Matricule17060/WirelessMonitoringProject/README.md

# WirelessMonitoringProject

https://user-images.githubusercontent.com/74556373/141704648-909ced50-29ef-4647-8402-63f720a56d8c.mp4
