Matricule17060/WirelessMonitoringProject/Annexes/Datasheet_Arduino.jpg

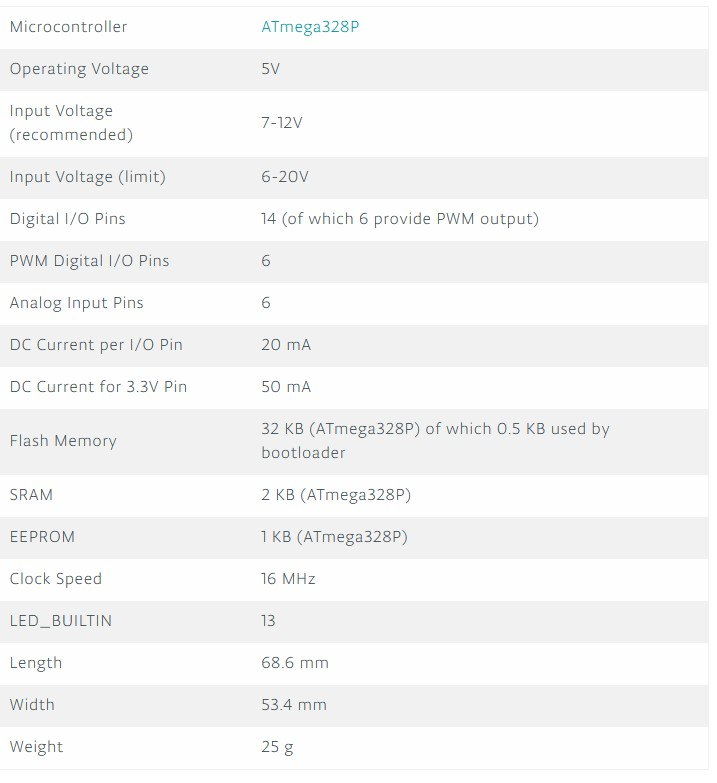
Annexes/Datasheet_Arduino.jpg
