Matricule17060/WirelessMonitoringProject/Annexes/MOTOR.PNG

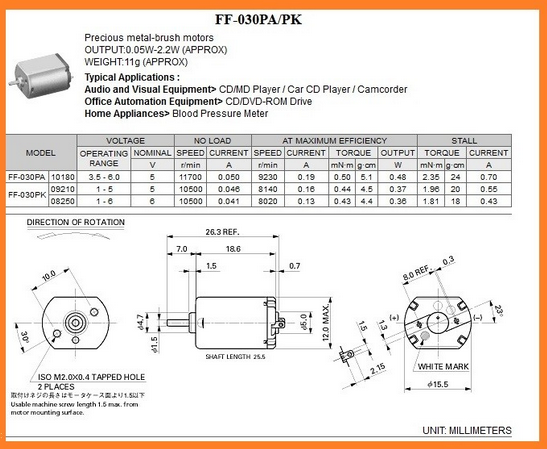
Annexes/MOTOR.PNG
