Matricule17060/WirelessMonitoringProject/Software/pulsOximeter/245952259_6285940131448196_2866411864842112487_n.png

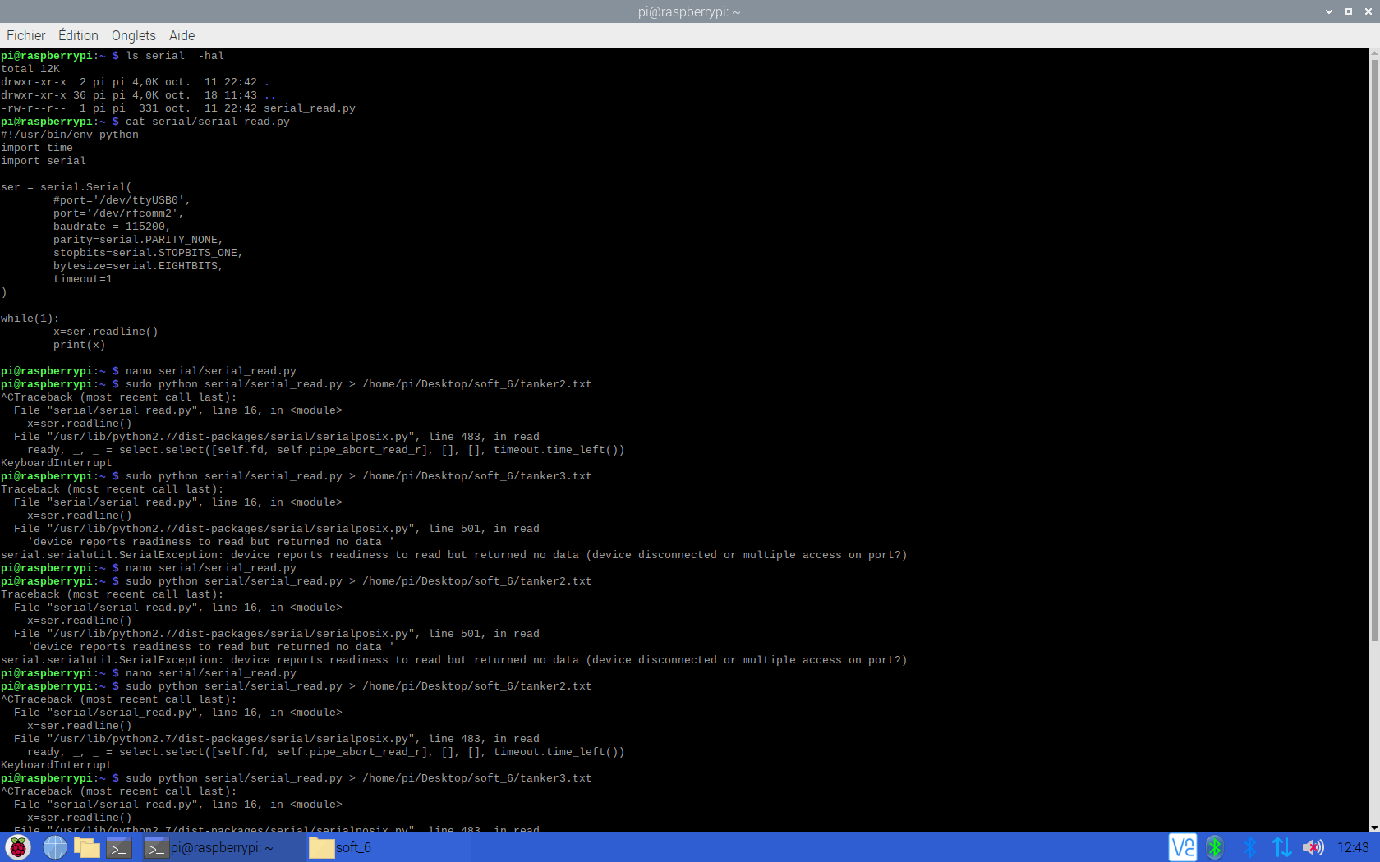
Software/pulsOximeter/245952259_6285940131448196_2866411864842112487_n.png
