Matricule17060/WirelessMonitoringProject/Software/pulsOximeter/plot1.PNG

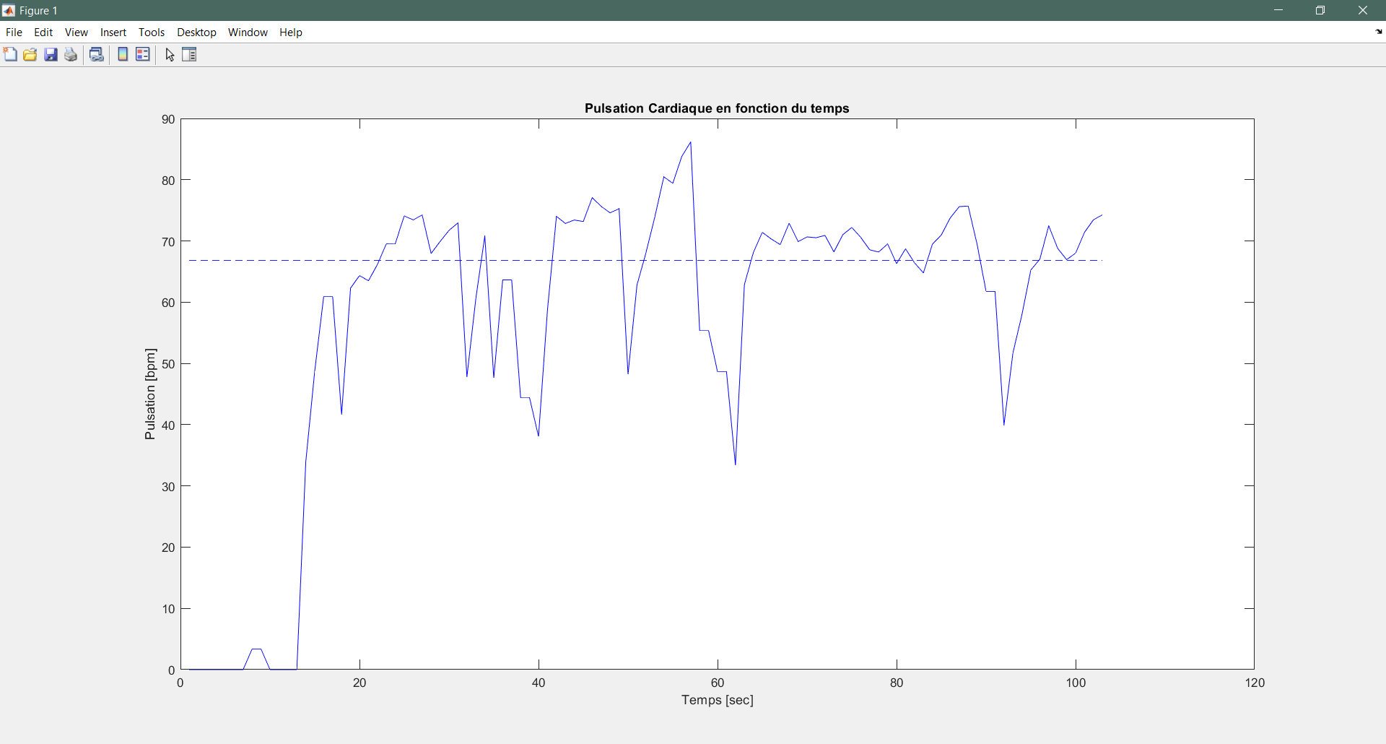
Software/pulsOximeter/plot1.PNG
