Matricule17060/WirelessMonitoringProject/Software/pulsOximeter/plot11.PNG

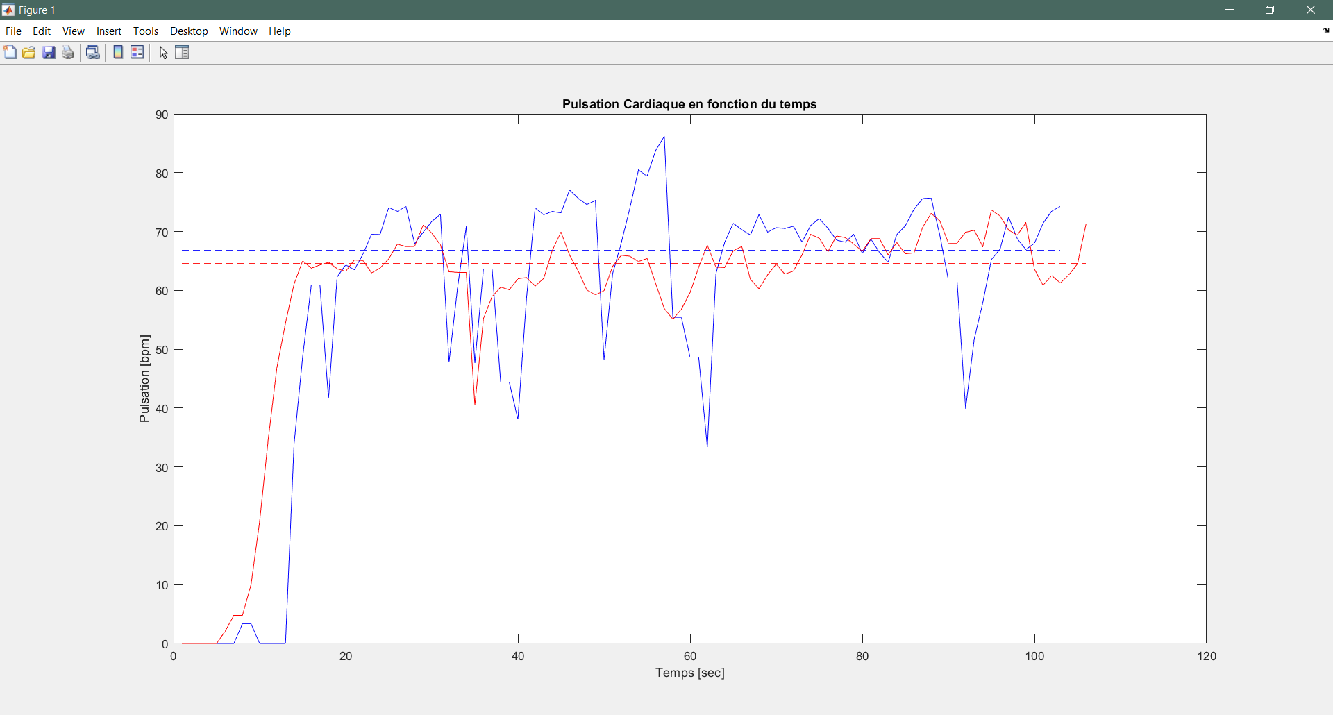
Software/pulsOximeter/plot11.PNG
