Matricule17060/WirelessMonitoringProject/Software/pulsOximeter/plot1111.PNG

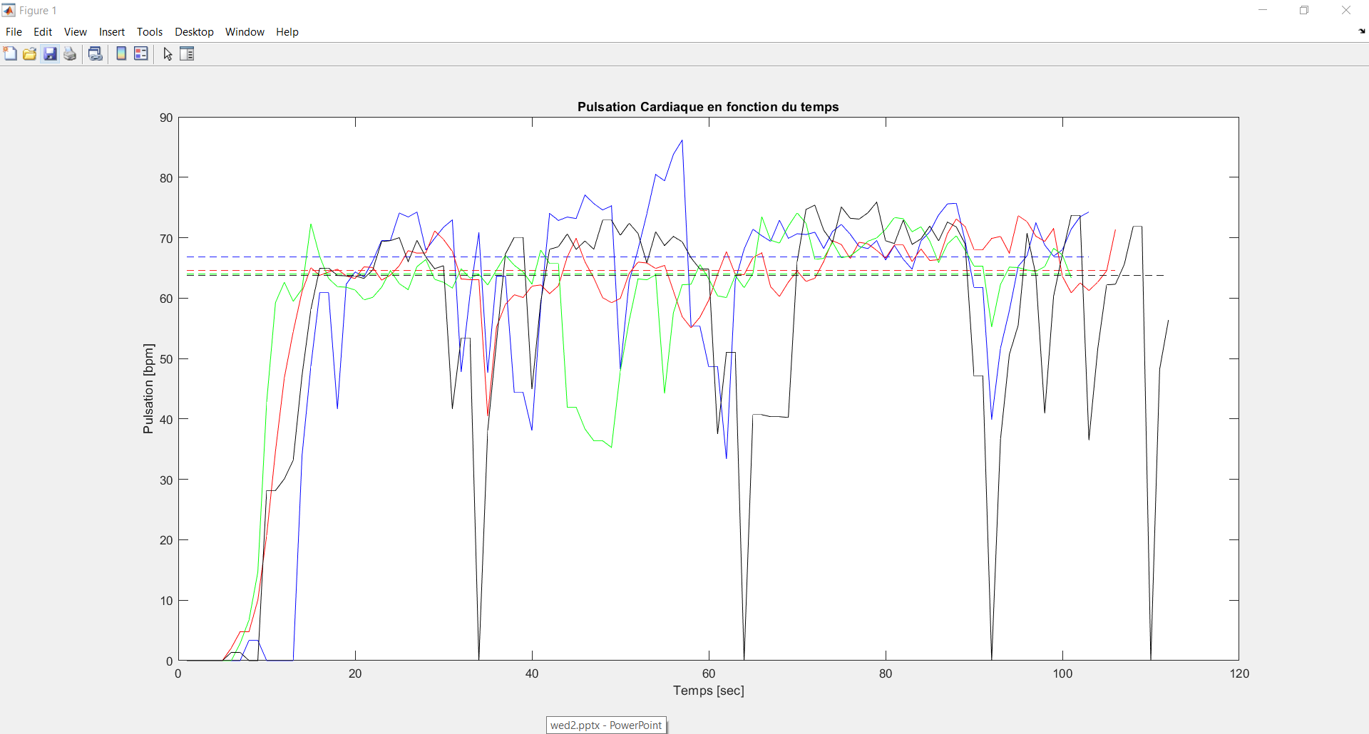
Software/pulsOximeter/plot1111.PNG
